patrickmoffitt/Adafruit-Feather-M0-Motion-Camera/(threads)

Thread 1 (2018-11-10):

OV5640 camera

SwiftFlying, 2018-11-10:
Hi,
Are you interested in making a better camera?
Using OV5640 and using LORA to transmit pictures over a long distance are mainly used for wildlife observation.

patrickmoffitt, 2018-11-10:
I am interested in making a better camera.

The Arducam Mini Module Camera Shield (OV5640) looks like a possible upgrade for the camera in this project. I'll take a closer look at it. Perhaps I'll add it to this project. Thanks for sharing.

I'm based in Pennsylvania USA. At present we don't have public LPWAN service. I did a pretty cursory search and it looks like I might be able to get service by joining a developer program. Lacking public LoRa LPWAN means the project would require an Internet gateway which ads cost and complexity to the build. Since the purpose of the project is to provide a hobbyist-level introduction I'm thinking that LoRa LPWAN isn't mature enough to be accessible just yet. I'd like to be wrong about that so please let me know where I can get public LPWAN if its available.

SwiftFlying, 2018-11-11:
Hi,
https://github.com/TomasTT7/LoRa_SSDV
I am working on this prototype.
There are few public gateways，We have 2 ways to solve this problem.
1.We can build a relay communication device.
2.Create a cheap LORA gateway.
https://www.tindie.com/products/will123321/sx1308-raspberry-pi-zero-lora-gateway-board/

http://www.heltec.cn/project/ht-m01-lora-gateway/

https://www.aliexpress.com/item/12MP-940nm-IR-Hunting-Camera-HC-300M-GPRS-GSM-Animal-Wildlife-Camera-free-shipping-by-Netherlands/1000002363178.html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

I think software is something you are good at.In hardware, I can design PCB and make prototypes.
In Shenzhen, China, I can find all kinds of components very conveniently.

Tom

Thread 2 (2019-03-15):

LORA&WiFi Camera

SwiftFlying, 2019-03-15:
Hi,
I'm very interested in the LORA Camera mentioned in your email，Can I add your Facebook?

patrickmoffitt, 2019-03-15:
I'm not on Facebook.

Also, I mentioned that I was able to find a LoRa service provider with a developer program. They only provide connectivity.

I did not mention a LoRa camera.

SwiftFlying, 2019-03-16:
We can add a LORA module to this module.Receiving also uses a LORA + ESP32 module。Use mobile phones to view pictures
https://pt.aliexpress.com/item/TTGO-T-C-mera-ESP32-WROVER-M-dulo-Da-C-mera-M-dulo-Da-C-mera/32968683765.html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

Of course, I can also add a camera to the module.
https://www.tindie.com/products/DLSpectrum/two-private-texting-lora-transceivers/#shipping

Thread 3 (2020-01-12):

Questions

krisbros, 2020-01-12:
Hello,

I am not a pro at electronics but i do belive that this camera need a wifi connection to send the pictures to Adafruit webpage? Since you have mounted the camera in your garden, and there it is wifi connection available. I want to build this camera and place it in the forest where there is no wifi connection at all. Maybe rather go for a micro sd card in the assembly, and how difficult is that(programming)? Im a new beginner at programming too,
Thanks for the project by the way, whery interesting. I want to do this because I want to learn about programming / electronics and I also need a wildlife camera.

Regards
Kristian

patrickmoffitt, 2020-01-12:
Hi Kristian,
Thanks for your interest in this project.

You are correct about the need for WiFi. The [microcontroller used in this project](https://www.adafruit.com/product/3010) includes the ATWINC1500 WiFi radio. To save the pictures to an SD card instead you could use [this variation](https://www.adafruit.com/product/2796) of the same line. You can find tutorials and sample code for the SD card functions on the Adafruit website.

Cheers,
Patrick Moffitt

Closed 2020-01-12.

Thread 4 (2020-03-15):

Schematic

krisbros, 2020-03-15:
Hello,
The Schematic drawing does not seems to be right compared with the description text.

- Transistor go to channel A1 on the Feather.
- PIR sensor output go to A0.

Some bacic question;
- The camera comes with a resistor, but why is this placed in the PIR sensor output?
- Can you describe the funktion of the transistor coupled in GND with the camera and the PIR.

Thanks again for the project.

Regards
Kristian

patrickmoffitt, 2020-03-15:
Hi @krisbros,

Thanks for pointing out that documentation error on the schematic and on the README.md. Both have now been corrected.

The camera comes with two resistors for making a resistor divider in the case where the camera is used on a micro-controller with 5V logic. See [this tutorial](https://learn.adafruit.com/ttl-serial-camera/using-commtool) for further details. The Feather M0 has 3.3V logic and so these were not needed in this project.

I apologize for the way the [PN2907A](https://cdn-shop.adafruit.com/product-files/3598/PN2907A-D.PDF) transistor was previously shown on the schematic. The version you were looking at lacked a wire-hop and gave the appearance that GND and 5V were connected between the PIR and CAMERA headers. This has since been corrected. Thank you for your question which brought the error to my attention.

As to how the transistor works; it basically works like a double-pole single-throw switch. It has 3 pins. The bottom one is pin 1 (the emitter). The left one is pin 2 (the base). The top one is pin 3 (the collector). The base pin (2) controls the flow of current between the emitter (1) and collector (3). In his type of transistor [(PNP)](https://learn.sparkfun.com/tutorials/transistors/all) current flows from the the emitter to the collector when the base is pulled low. In my circuit this has the effect of connecting the camera's ground pin to ground and allowing current to flow through the camera to ground. This use of transistors is called switching the current sink. Here is [another tutorial](https://www.petervis.com/GCSE_Design_and_Technology_Electronic_Products/Transistor_as_a_Switch/Transistor_as_a_Switch.html) you may find helpful to understanding transistors. When the base is pulled high the flow of current stops. In my circuit this shuts off the camera (to save power).

Cheers,
Patrick Moffitt

krisbros, 2020-03-16:
Hello Patrick,
Thanks alot! Will be working with this project for a while. It will be interesting to see if I manage to solve the programming i C++. That is the main focus now. I use the feather adalogger in my project. I have also thought about develop some new funktions, but first solve the things I already have started.

Regards
Kristian

Closed 2020-03-15.
