patrickmoffitt/Adafruit-Feather-M0-Motion-Camera/src/motion_camera_secrets.hpp

#ifndef MOTION_CAMERA_SECRETS_HPP
#define MOTION_CAMERA_SECRETS_HPP

#define WIFI_SSID "The name of your WiFi router"
#define WIFI_PASS "The WiFi password"
#define AIO_USERNAME "Your Adafruit user name"
#define AIO_KEY "Your secret AIO key"

#endif //MOTION_CAMERA_SECRETS_HPP
