patrickmoffitt/Adafruit-Feather-M0-Motion-Camera/(commit log)

2018-08-25 Arduino IDE specific changes. main.cpp has become Adafruit_Feather_M0_Motion_Camera.ino. Where the platformio brach has its secrets in platformio.ini the arduino branch keeps its secrets in motion_ca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
2018-08-25 main.cpp is not needed in the arduino branch.
2018-08-25 Adjustments to support Arduino.
2018-08-26 Improved outline and white-space for readability and supportability. Hit the save button in Atom.
2018-08-26 Added sample image and a word or two about image color.
2018-08-28 Added notes about the schematic.
2020-03-15 Corrected PIN assingments. Thanks to @krisbros for pointing out my mistake.
2020-03-15 Moved 5V wire connecting PIR and CAMERA headers to correct the appearance of a connection to ground. I couldn't get DRAW.IO to add a wire hop where it was needed.
